KyleRenwick/Butterfly-Switch/README.md

# Butterfly-Switch
Lever switches for providing access for people with disabilities

This project is intended to provide a set of open-source switches that can be customized to meet the particular needs of individuals with disabilities.

Kyle Renwick
2016-02-18
