KyleRenwick/Butterfly-Switch/Butterfly Switch Base.iges

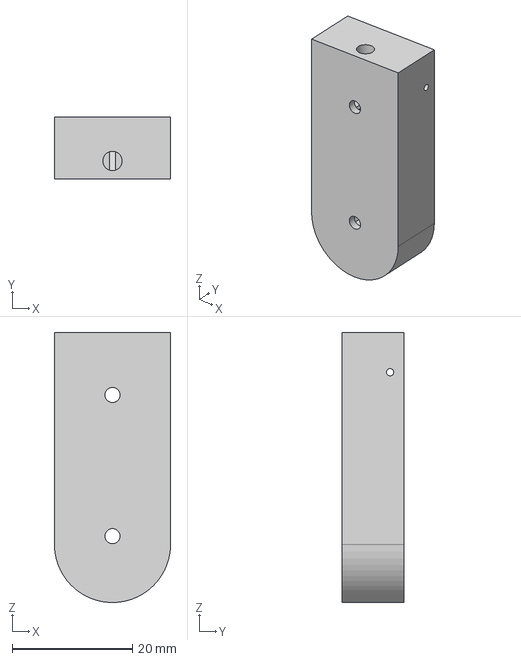
[picture p1: CAD file, 2016-03-27]
Butterfly Switch Base.iges
19.3 x 10.3 x 44.8 mm
