KyleRenwick/Butterfly-Switch/Butterfly Switch Clip.iges

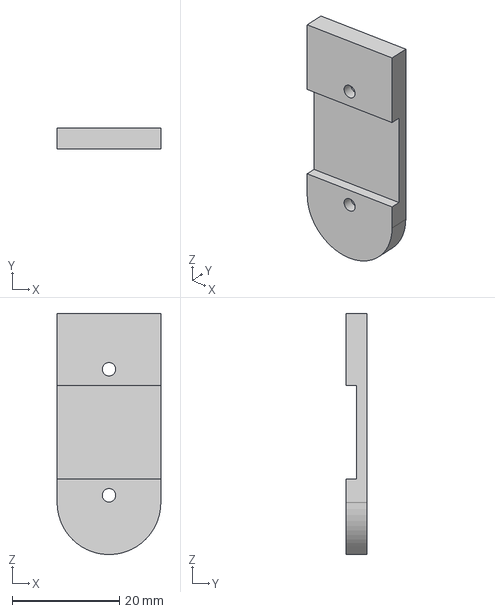
[picture p2: CAD file, 2016-03-20]
Butterfly Switch Clip.iges
19.3 x 4.00 x 44.8 mm
