KyleRenwick/Butterfly-Switch/Butterfly Switch Top.iges

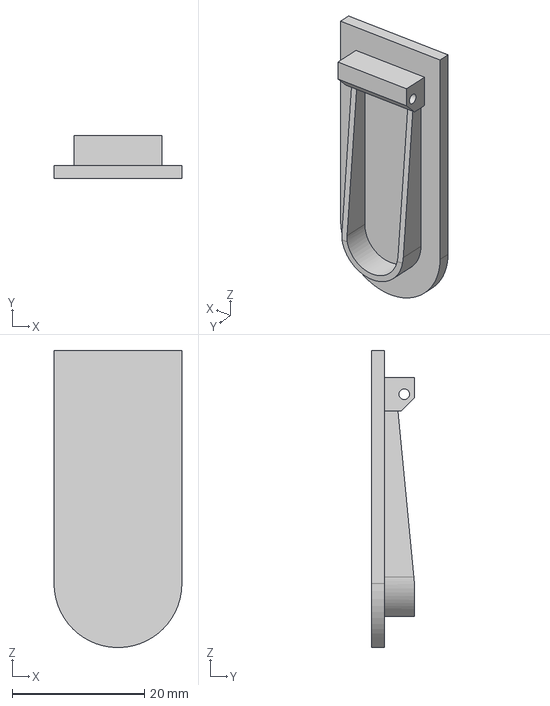
[picture p3: CAD file, 2016-03-20]
Butterfly Switch Top.iges
19.3 x 6.50 x 44.8 mm
