KyleRenwick/Butterfly-Switch/Butterfly Switch Flat Base.iges

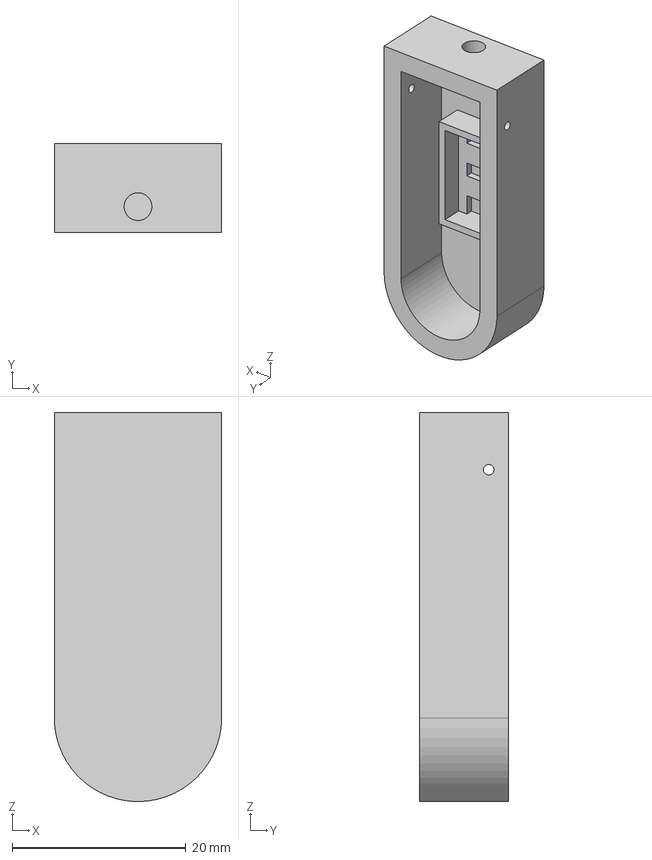
[picture p4: CAD file, 2016-03-20]
Butterfly Switch Flat Base.iges
19.3 x 10.3 x 44.8 mm
