KyleRenwick/Butterfly-Switch/Butterfly Switch Tabbed Base.iges

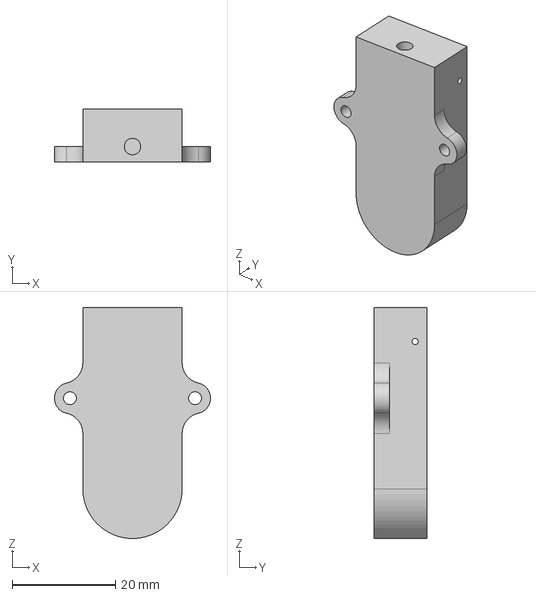
[picture p5: CAD file, 2016-03-20]
Butterfly Switch Tabbed Base.iges
30.3 x 10.3 x 44.8 mm
