KyleRenwick/Butterfly-Switch/(list of files, cad)

Other CAD files:
Butterfly Switch Base.f3d
Butterfly Switch Base.stl
Butterfly Switch Clip.f3d
Butterfly Switch Clip.stl
Butterfly Switch Flat Base.f3d
Butterfly Switch Flat Base.stl
Butterfly Switch Tabbed Base.f3d
Butterfly Switch Tabbed Base.stl
Butterfly Switch Top.f3d
Butterfly Switch Top.stl
