KyleRenwick/Butterfly-Switch/(commit log)

2016-03-20 Initial import of Butterfly Switch
    This is v1.0 of the Butterfly Switch.
    [Butterfly Switch Base.f3d, Butterfly Switch Base.iges, Butterfly Switch Base.stl, Butterfly Switch Clip.f3d, Butterfly Switch Clip.iges, Butterfly Switch Clip.stl, Butterfly Switch Flat Base.f3d, Butterfly Switch Flat Base.iges]
2016-03-21 Reorganization
    Moved around a lot of the files so that the folder structure makes more
    sense.
    [Butterfly Switch Base.f3d, Butterfly Switch Base.iges, Butterfly Switch Base.stl, Butterfly Switch Clip.f3d, Butterfly Switch Clip.iges, Butterfly Switch Clip.stl, Butterfly Switch Flat Base.f3d, Butterfly Switch Flat Base.iges]
2016-03-27 Added a rib to the hex standoff holder
    The rib prevents the hex standoff holder from breaking during assembly
    of the switch.
    Also updated the instructions with a picture.
    [Butterfly Switch Base.f3d, Butterfly Switch Base.iges, Butterfly Switch Base.stl]
